twaymouth/XGT-Tester/(threads)

Thread 1 (2024-10-23):

Uart Librarie

ur-hail, 2024-10-23:
Hi,

I’m trying to run your code on an Arduino and noticed that you use #include "driver/uart.h", but I couldn’t find that file anywhere. I tried using the standard #include <SoftwareSerial.h>, but I’m running into some issues with it as well. Could you provide the source code for the library, or am I missing something?

twaymouth, 2024-10-23:
The code example provided is specifically for the ESP32 family of microcontrollers which uart.h is unique to. If you are using a different microcontroller family then uart.h will be irrelevant and the code will need to be alerted to suit your chosen platform.

If you would like I can write a universal example using software serial however it might take a few weeks as I am a bit busy at the moment.

ur-hail, 2024-10-24:
Hey Twaymouth,
That would be great. In the meantime, I’ll try to get it working anyway. If I succeed, I’ll send you the update for it. The plan is for this script to ultimately run on a Raspberry Pi (Zero) so that this data can be sent via Ethernet using MQTT. Thanks in advance for the quick response! :)

ur-hail, 2024-10-30:
After some testing with the specific electronics you are using (exept for the button --> removed the code), I still did not managed to get it working (Error Communicating With Battery). The serial data has been tested back and forward with a arduino to make sure the schematic, connections,... are connected properly. I tryd to put some additional println's in the code (for example
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 ).
Do you have some tips to debug it on other ways to analyze where my problem could be, or do you have other suggestions i need to take a look at? The battery i am using is the 8Ah version.
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
I appriciate that you are doing this open source but if you want a penny for the time troubleshooting, i am willing to give some sice this is a major thing to get this working.

twaymouth, 2024-10-30:
Happy to help you get it sorted however I am currently away from my
workspace for a few days and only have a phone with me.

I return on the 6th of November and will send you a few suggestions for
some more advanced troubleshooting after that.

All I can suggest right now is put in a couple of debug prints to
understand where it is failing.

 is it failing because no data is being received from the battery or is it
due to a crc error or is it due to specific commands failing ( if one
command fails it returns nothing even if others succeed) etc. Very basic
but I assume you changed lines 3 / 4 to match your hardware setup.

I tested with a 2.5ah, 5ah and 8ah battery and they all worked, not sure if
batteries vary country to country? Hard to know.

Will get back to you shortly after the 6th.

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

twaymouth, 2024-11-06:
Short a

twaymouth, 2024-11-06:
Short answer is I know what the issue is and was able to reproduce it, long answer it is going to take a bit of time to work out how to address it in relation to your specific hardware:

In my connection schematic I show a level converter similar to this one:
[Bi directional converter](https://www.sparkfun.com/products/12009)

However what I used when I built it is one like this:
[Non bi directional converter](https://ae01.alicdn.com/kf/Sa83504ae74634ef5ad1ded11a2958642A.jpg_640x640q90.jpg)

When I tested with the first type I experienced the same issue as you and could not communicate with the battery, with the second type (Non bi directional) it worked as expected.

I will do some more testing and come up with a solution.

ur-hail, 2024-11-07:
Thank you for the clarification! This was the problem indeed. There is one small problem with the ESP32 board, where the controller get an unhandled error after 2 to 3 good runs (removed the button code and looped it) and rebooted. But this was 'dirty' fixed by removing the specific code that caused the problem ( the specific send battery function where the model type has been asked to the battery). Little strange but somehting that is only a 'nice to have' thing.  I cannot say this enough but i am really happy you helped me figuring this one out.  :).

twaymouth, 2024-11-07:
No problem, I saw the same issue as you with a reboot after a few runs, also not sure what is causing this but I am looking into it. I have ordered a few different models of level converter to do additional testing and will update my github page once I come to a conclusion.

twaymouth, 2024-11-08:
Ok, I found an issue with my code where it was writing into the ESP32s memory space and crashing it when retrieving the model, I have published an updated version including the fixes. (lines 61,66,88,100).

With these fixes the reboots are no longer seen and it is slightly more reliable in communicating with the battery.

Closed 2025-07-30.

Thread 2 (2025-07-28):

Battery pin naming wrong?

clowrey, 2025-07-28:
You can see here that the pin you have labeled DT is actually the TR pin on the PCB?

I think this is just a naming issue as that is still the correct pin, its just called TR (Transmit / Receive) on the PCB and in the makita patent as shown on this thread https://www.laptopu.ro/community/power-tools-battery-pinout/makita-bl4040-pinout/

Just confused me a little so thought I would pass it on :)

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

Thanks for this repo I really appreciate it! I modified a Makita battery power connector 3d print that uses OEM terminal block so wanted this to monitor the battery SOC as I use it in another tool.

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

clowrey, 2025-07-29:
Yup I'm using your code to make an ESPhome project that wil log my battery and control some sort of switch discharge cutoff switch, I haven't decided exactly what that will look like. Also it will have an LCD display to show the battery SOC locally.

clowrey, 2025-07-30:
Got most of it working in ESPhome as an external component! after fighting with serial port parity and inversion for awhile..

Also getting by with no level shifter ;) I tried it first with..

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

clowrey, 2025-07-30:
Got mine up in a repo!! I gave you credit at the bottom - definitely couldn't have done it without your source.
Also Claude 4 Sonnet did the whole porting.. It would have taken me a month with my coding skills to make the external component..
https://github.com/clowrey/ESPHome-XGT

twaymouth, 2025-07-30:
Thanks, that looks really good. The dev board with a built in display is a nice touch, makes it good starting point for someone else who wants to make one for themselves without purchasing a lot of specific hardware.

twaymouth, 2025-07-30:
Documentation updated with correct pinout.

clowrey, 2025-07-30:
I shared it on the ESPhome discord and ssib shared his half duplex UART config! so it now works with just one GPIO and one resistor :)
https://discord.com/channels/429907082951524364/1400005985552302221

his half duplex stuff is here.. I am updating my repo now for that config
https://github.com/ssieb/esphome/tree/uarthalf/esphome/components/uart

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

Closed 2025-07-30.

Thread 3 (2025-09-30):

Factory reset commands deactivate the battery definitely

marccap2002, 2025-09-30:
I managed to communicate with my BL4080F battery following your diagram, I wanted to find out what was happening with the battery, since it stopped charging and was doing the famous dance of lights.
The battery was at 86% SOH, correct voltages and with the lock status at 0 according to the information that the battery returned thanks to your code.
So far so good, but when I send the factory reset, it returns "Battery accepted reset command", the battery LEDs no longer light up, and I no longer get responses. It seems as if the BMS has been deactivated forever.

Do you know anything else I can try to recover the battery's life?
Thanks.

twaymouth, 2025-10-01:
That's a pain, sounds like the cells are ok but the bms has failed.

I would honestly try and warranty it with makita (probably don't mention the diy reset attempt) like yes the reset broke it but it sounds like it was already faulty prior to that. Even if you are outside the warranty period makita are usually pretty good about goodwill replacements depending how far out the warranty is.
