twaymouth/XGT-Tester/(commit log)

2024-11-08 Update XGT_Battery_ESP32.ino
    Fix bug causing ESP32 crash.
    Improve retry mechanism, allow slightly more time for battery to respond.
    [XGT_Battery_ESP32.ino]
2025-07-30 Add files via upload
    Update battery picture with correct pinout.
2025-07-30 Update README.md
    Correct battery pinout.
2025-09-03 Update XGT_Battery_ESP32.ino
    Update to allow battery to be reset, get lock status and get 2nd temp sensor
    [XGT_Battery_ESP32.ino]
